JulianStremel/mrdiy_canabus/README.md

This project comprises a combination of software and hardware components designed to extract Controller Area Network (CAN) messages and generate practical gadgets. The primary objective is to receive CAN messages from a bus, extract the CAN-ID and Data from them, and subsequently transmit this information over ESPNow. The gadgets serve as ESPNow receivers, responsible for filtering and processing the received CAN-IDs and data to perform specific useful tasks.

## How to Install The Code

Certain firmware options (Gateway and Gadgets) can be conveniently installed online onto ESP32/ESP8266 devices with just a single click using the Chrome browser at <a href='https://mrdiyca.gitlab.io/mrdiy-esp-online-flasher'>https://mrdiyca.gitlab.io/mrdiy-esp-online-flasher</a>

## 3D Printable Files

You can find the STL files at my <a href='https://makerworld.com/en/@mrdiy'>MakerWorld profile</a>.

## The Gateway / Bridge

The gateway, sometimes called the bridge, consists of an ESP32 Dev Kit 1 board paired with a CAN bus shield (see below), directly connected to the car's CAN bus, typically via the OBDII port. See my full video below.

Gateway = ESP32 + Shield

MrDIY Wireless Gateway YouTube video (https://www.youtube.com/watch?v=XiqU5wpnupk)

<table>
<tr>

<td>
Power consumption while active: <100mA 

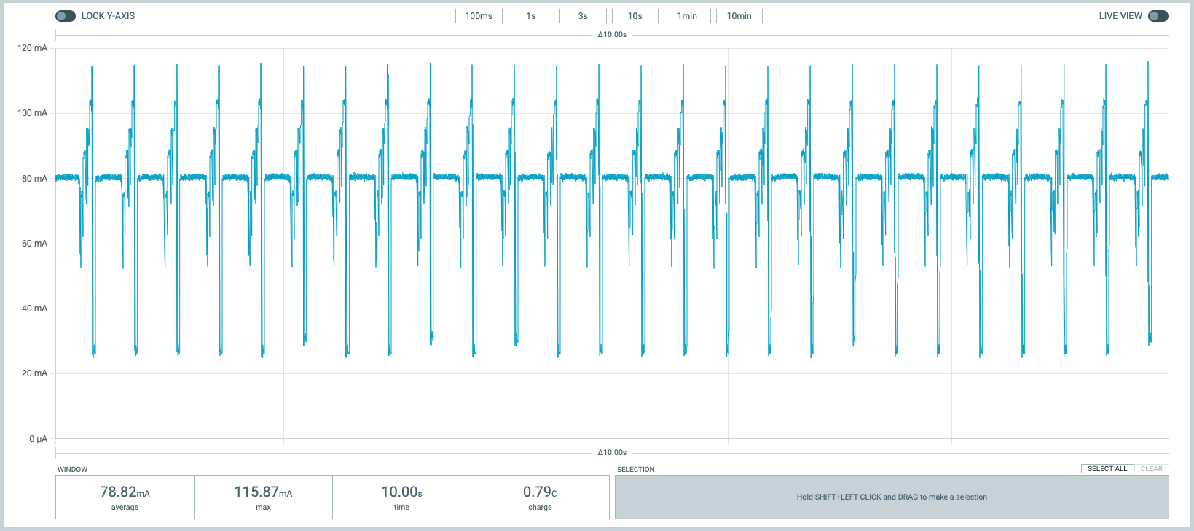
[picture p1: img/power_usage_active.png]
</td>
<td>
While asleep w/o LEDs: <10 mA 

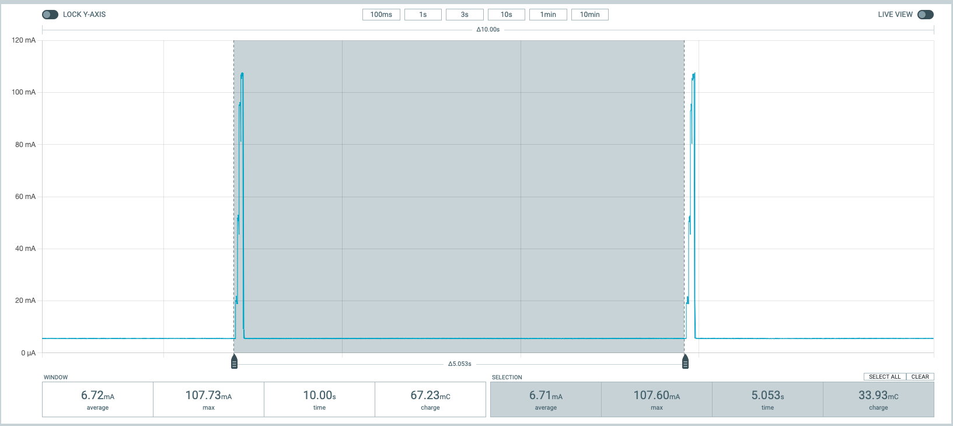
[picture p2: img/power_usage_idle.png]


</td>

</tr>
</table>

## SavvyCAN

I got SavvyCAN to work on the gateway. More details: https://youtu.be/NDBkXGyBT88
<br>The source code is inside the /esp32_savvycan folder
<br>Online flasher at https://mrdiyca.gitlab.io/mrdiy-esp-online-flasher

MrDIY CAN Shield YouTube video (https://www.youtube.com/watch?v=NDBkXGyBT88)

## The Shield

Get the ESP32 <a href="https://store.mrdiy.ca/p/esp32-can-bus-shield/"> CAN Shield here.</a>

I designed a shield for the ESP32 Dev Kit 1 board [<a href='https://geni.us/jS2Lx1W'>Amazon</a>, <a href='https://s.click.aliexpress.com/e/_DmhOymx'>AliExpress</a>] that adds a CAN bus transceiver and steps down the car's battery voltage down to a usable 3.3v.

MrDIY CAN Shield YouTube video (https://www.youtube.com/watch?v=Se2KCVyD7CM)

<br>**Version 1.0**: the original shield
<br>**Version 1.1**: added a voltage divider on GPIO32, a 120Ω CAN termination resistor, and a physical toggle switch enabling the CAN transceiver to toggle between “Listen-only” and “Do-Not-Transmit” modes.
<br>**Version 1.2 (current)**: added an OBD2 connector pinout, an extra LED on GPIO27, layout improvement, larger text, relocation of solder-jumpers to the top side, and the creation of a custom 3D printable case.

<br>

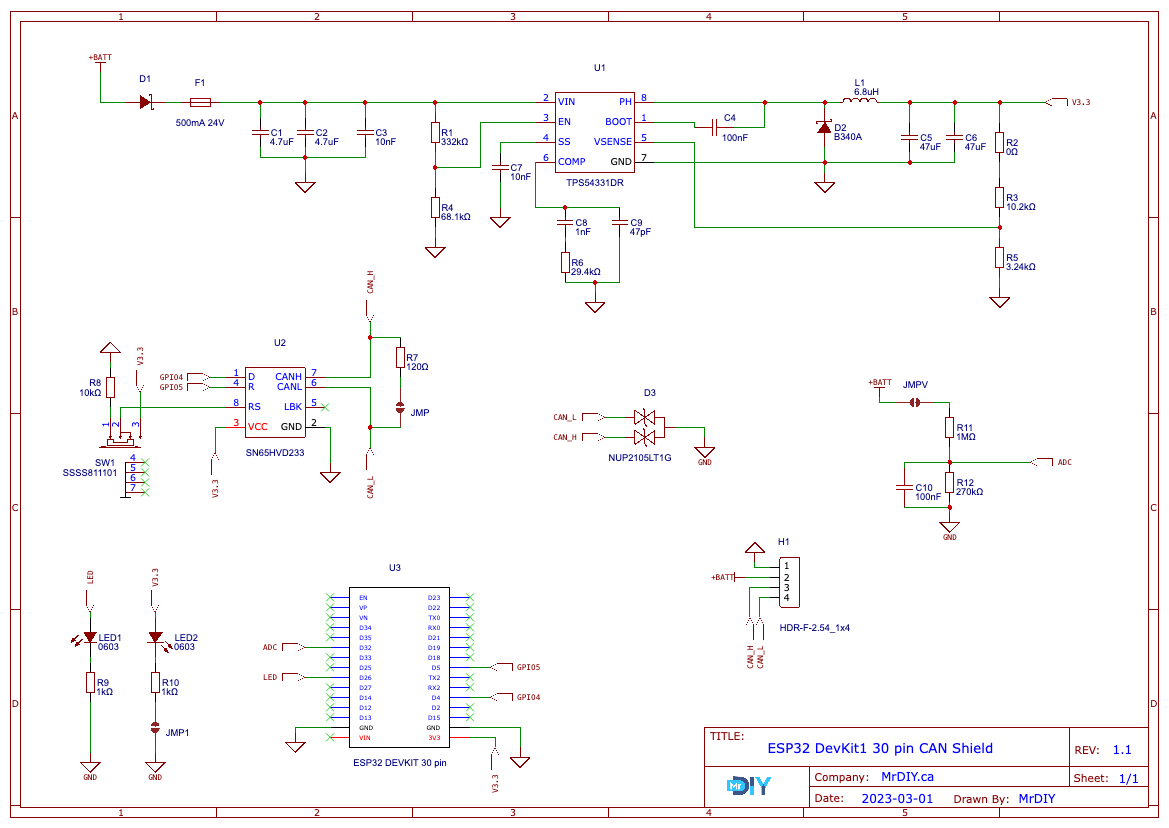
[picture p3: img/schematic_can_shield__esp32_v1.2.png]
Schematic


## The Gadgets

### Tesla Display

This gadget is a speedometer & battery SoC display screen for Tesla Model 3/Y.
<br>Online flasher at https://mrdiyca.gitlab.io/mrdiy-esp-online-flasher

MrDIY Gadget: Tesla Display YouTube video (https://www.youtube.com/watch?v=RgQMdmYFQI0)

### Garage door opener

This gadget waits for a signal from the car to trigger a relay to open or close a garage door. 
<br>The source code is inside the /gadget_garage_opener folder
<br>Online flasher at https://mrdiyca.gitlab.io/mrdiy-esp-online-flasher

MrDIY Gadget: Garage Door Opener YouTube video (https://www.youtube.com/watch?v=PJhCqS9ZGLU)

### SLCAN/LAWICEL & SavvyCAN

This gadget converts the ESPNow CAN messages into SLCAN/LAWICEL format to allow it to be used with SavvyCAN for sniffing, monitoring, analyzing and decoding CAN messages. 
<br>The source code is inside the /gadget_savvycan folder
<br>Online flasher at https://mrdiyca.gitlab.io/mrdiy-esp-online-flasher

MrDIY Gadget: SavvyCAN on ESP8266 YouTube video (https://www.youtube.com/watch?v=pontoaAcyZM)

### Other Gadgets

coming soon ...

## License

This project is licensed under the Creative Commons Attribution-NonCommercial-ShareAlike 4.0 International License.
