JulianStremel/mrdiy_canabus/img/gadget_tesla_screen.png

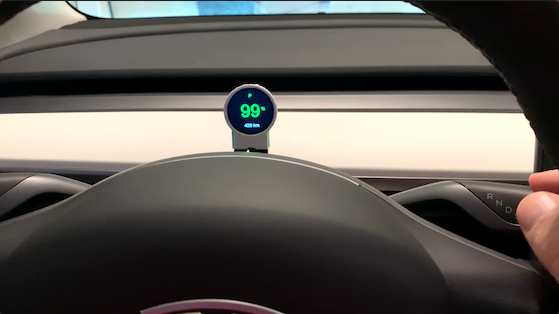
img/gadget_tesla_screen.png
