JulianStremel/mrdiy_canabus/img/savvycan.png

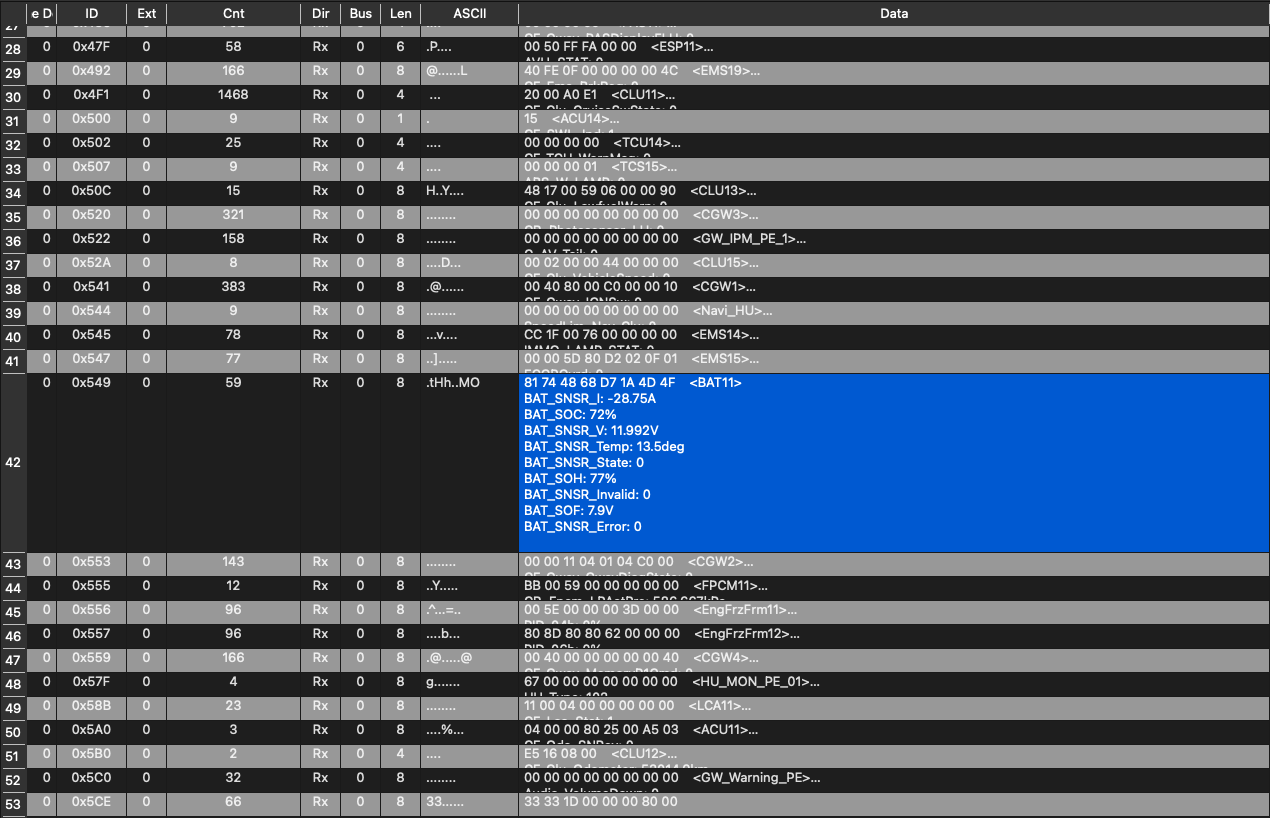
img/savvycan.png
