JulianStremel/mrdiy_canabus/esp32_savvycan/src/config.h

/*
 * config.h
 *
 * allows the user to configure static parameters.
 *
 * Note: Make sure with all pin defintions of your hardware that each pin number is
 *       only defined once.

 Copyright (c) 2013-2020 Collin Kidder, Michael Neuweiler, Charles Galpin

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
THE SOFTWARE IS PROVIDED "AS IS", WITHOUT WARRANTY OF ANY KIND,
EXPRESS OR IMPLIED, INCLUDING BUT NOT LIMITED TO THE WARRANTIES OF
MERCHANTABILITY, FITNESS FOR A PARTICULAR PURPOSE AND NONINFRINGEMENT.
IN NO EVENT SHALL THE AUTHORS OR COPYRIGHT HOLDERS BE LIABLE FOR ANY
CLAIM, DAMAGES OR OTHER LIABILITY, WHETHER IN AN ACTION OF CONTRACT,
TORT OR OTHERWISE, ARISING FROM, OUT OF OR IN CONNECTION WITH THE
SOFTWARE OR THE USE OR OTHER DEALINGS IN THE SOFTWARE.
*/

#ifndef CONFIG_H_
#define CONFIG_H_

#include <WiFi.h>
#include "esp32_can.h"
#include <Preferences.h>

//size to use for buffering writes to USB. On the ESP32 we're actually talking TTL serial to a TTL<->USB chip
#define SER_BUFF_SIZE       1024

//Buffer for CAN frames when sending over wifi. This allows us to build up a multi-frame packet that goes
//over the air all at once. This is much more efficient than trying to send a new TCP/IP packet for each and every
//frame. It delays frames from getting to the other side a bit but that's life.
//Probably don't set this over 2048 as the default packet size for wifi is 2312 including all overhead.
#define WIFI_BUFF_SIZE      2048

//Number of microseconds between hard flushes of the serial buffer (if not in wifi mode) or the wifi buffer (if in wifi mode)
//This keeps the latency more consistent. Otherwise the buffer could partially fill and never send.
#define SER_BUFF_FLUSH_INTERVAL 20000

#define CFG_BUILD_NUM   618
#define CFG_VERSION "Alpha Nov 29 2020"
#define PREF_NAME   "ESP32RET"
#define EVTV_NAME   "ESP32RET"
#define MACC_NAME   "CAN"

#define MARK_LIMIT  6   //# of our analog input pins to use for marking. Defaults to all of them. Send voltage to pin to trigger it

#define NUM_ANALOG  NUM_ANALOG_INPUTS   // we get the number of analogue inputs from variant.h
#define NUM_DIGITAL 6   // Not currently using digital pins on the ESP32
#define NUM_OUTPUT  6   // Ditto

#define NUM_BUSES   5   //max # of buses supported by any of the supported boards

//It's not even used on this hardware currently. But, slows down the blinks to make them more visible
#define BLINK_SLOWNESS  100 

#define A0_LED_PIN     33
#define A0_NUM_LEDS    0
#define A5_LED_PIN     25
#define A5_NUM_LEDS    0
#define BRIGHTNESS  190
#define LED_TYPE    WS2812B
#define COLOR_ORDER GRB

#define SW_EN     2
#define SW_MODE0  26
#define SW_MODE1  27

//How many devices to allow to connect to our WiFi telnet port?
#define MAX_CLIENTS 1

struct FILTER {  //should be 10 bytes
    uint32_t id;
    uint32_t mask;
    boolean extended;
    boolean enabled;
} __attribute__((__packed__));

struct CANFDSettings {
    uint32_t nomSpeed;
    uint32_t fdSpeed;
    boolean enabled;
    boolean listenOnly;
    boolean fdMode;
};

struct EEPROMSettings {
    CANFDSettings canSettings[NUM_BUSES];

    boolean useBinarySerialComm; //use a binary protocol on the serial link or human readable format?

    uint8_t logLevel; //Level of logging to output on serial line
    uint8_t systemType; //0 = A0RET, 1 = EVTV ESP32 Board, 2 = Macchine 5-CAN board
    
    boolean enableBT; //are we enabling bluetooth too?
    char btName[32];

    boolean enableLawicel;

    //if we're using WiFi then output to serial is disabled (it's far too slow to keep up)  
    uint8_t wifiMode; //0 = don't use wifi, 1 = connect to an AP, 2 = Create an AP
    char SSID[32];     //null terminated string for the SSID
    char WPA2Key[64]; //Null terminated string for the key. Can be a passphase or the actual key
} __attribute__((__packed__));

struct SystemSettings {
    uint8_t LED_CANTX;
    uint8_t LED_CANRX;
    uint8_t LED_LOGGING;
    uint8_t LED_CONNECTION_STATUS;
    boolean fancyLED;
    boolean txToggle; //LED toggle values
    boolean rxToggle;
    boolean logToggle;
    boolean lawicelMode;
    boolean lawicellExtendedMode;
    boolean lawicelAutoPoll;
    boolean lawicelTimestamping;
    int lawicelPollCounter;
    boolean lawicelBusReception[NUM_BUSES]; //does user want to see messages from this bus?
    int8_t numBuses; //number of buses this hardware currently supports.
    WiFiClient clientNodes[MAX_CLIENTS];
    WiFiClient wifiOBDClients[MAX_CLIENTS];
    boolean isWifiConnected;
    boolean isWifiActive;
};

class GVRET_Comm_Handler;
class SerialConsole;
class CANManager;
class LAWICELHandler;
class ELM327Emu;

extern EEPROMSettings settings;
extern SystemSettings SysSettings;
extern Preferences nvPrefs;
extern GVRET_Comm_Handler serialGVRET;
extern GVRET_Comm_Handler wifiGVRET;
extern SerialConsole console;
extern CANManager canManager;
extern LAWICELHandler lawicel;
extern ELM327Emu elmEmulator;
extern char deviceName[20];
extern char otaHost[40];
extern char otaFilename[100];
extern CAN_COMMON *canBuses[NUM_BUSES];

#endif /* CONFIG_H_ */
