JulianStremel/mrdiy_canabus/esp32_savvycan/src/ESP32RET.ino

/*
 ESP32RET.ino

 Created: June 1, 2020
 Author: Collin Kidder

Copyright (c) 2014-2020 Collin Kidder, Michael Neuweiler

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
THE SOFTWARE IS PROVIDED "AS IS", WITHOUT WARRANTY OF ANY KIND,
EXPRESS OR IMPLIED, INCLUDING BUT NOT LIMITED TO THE WARRANTIES OF
MERCHANTABILITY, FITNESS FOR A PARTICULAR PURPOSE AND NONINFRINGEMENT.
IN NO EVENT SHALL THE AUTHORS OR COPYRIGHT HOLDERS BE LIABLE FOR ANY
CLAIM, DAMAGES OR OTHER LIABILITY, WHETHER IN AN ACTION OF CONTRACT,
TORT OR OTHERWISE, ARISING FROM, OUT OF OR IN CONNECTION WITH THE
SOFTWARE OR THE USE OR OTHER DEALINGS IN THE SOFTWARE.
 */
#include "config.h"
#include <esp32_can.h>
#include <SPI.h>
#include <Preferences.h>
#include <FastLED.h>
#include "ELM327_Emulator.h"
#include "SerialConsole.h"
#include "wifi_manager.h"
#include "gvret_comm.h"
#include "can_manager.h"
#include "lawicel.h"

byte i = 0;

uint32_t lastFlushMicros = 0;

bool markToggle[6];
uint32_t lastMarkTrigger = 0;

EEPROMSettings settings;
SystemSettings SysSettings;
Preferences nvPrefs;
char deviceName[20];
char otaHost[40];
char otaFilename[100];

uint8_t espChipRevision;

ELM327Emu elmEmulator;

WiFiManager wifiManager;

GVRET_Comm_Handler serialGVRET; //gvret protocol over the serial to USB connection
GVRET_Comm_Handler wifiGVRET; //GVRET over the wifi telnet port
CANManager canManager; //keeps track of bus load and abstracts away some details of how things are done
LAWICELHandler lawicel;

SerialConsole console;

CRGB leds[A5_NUM_LEDS]; //A5 has the largest # of LEDs so use that one even for A0 or EVTV

CAN_COMMON *canBuses[NUM_BUSES];

//initializes all the system EEPROM values. Chances are this should be broken out a bit but
//there is only one checksum check for all of them so it's simple to do it all here.
void loadSettings()
{
    Logger::console("Loading settings....");

    //Logger::console("%i\n", espChipRevision);

    for (int i = 0; i < NUM_BUSES; i++) canBuses[i] = nullptr;

    nvPrefs.begin(PREF_NAME, false);

    settings.useBinarySerialComm = nvPrefs.getBool("binarycomm", false);
    settings.logLevel = nvPrefs.getUChar("loglevel", 1); //info
    settings.wifiMode = nvPrefs.getUChar("wifiMode", 2); //Wifi defaults to creating an AP
    //settings.enableBT = nvPrefs.getBool("enable-bt", false);
    settings.enableBT = nvPrefs.getBool("enable-bt", true); // change julian
    settings.enableLawicel = nvPrefs.getBool("enableLawicel", true);
    settings.systemType = 0; //nvPrefs.getUChar("systype", (espChipRevision > 2) ? 0 : 1); //0 = A0, 1 = EVTV ESP32

    if (settings.systemType == 0)
    {
        canBuses[0] = &CAN0;
        SysSettings.LED_CANTX = 26;
        SysSettings.LED_CANRX = 27;
        SysSettings.LED_LOGGING = 35;
        SysSettings.LED_CONNECTION_STATUS = 0;
        SysSettings.fancyLED = false;
        SysSettings.logToggle = false;
        SysSettings.txToggle = true;
        SysSettings.rxToggle = true;
        SysSettings.lawicelAutoPoll = false;
        SysSettings.lawicelMode = false;
        SysSettings.lawicellExtendedMode = false;
        SysSettings.lawicelTimestamping = false;
        SysSettings.numBuses = 1;
        SysSettings.isWifiActive = false;
        SysSettings.isWifiConnected = false;
        strcpy(deviceName, MACC_NAME);
        strcpy(otaHost, "");
        strcpy(otaFilename, "");
        pinMode(SysSettings.LED_CANTX, OUTPUT);
        pinMode(SysSettings.LED_CANRX, OUTPUT);
        digitalWrite(SysSettings.LED_CANTX, LOW);
        digitalWrite(SysSettings.LED_CANRX, LOW);
        delay(100);
        FastLED.addLeds<LED_TYPE, A0_LED_PIN, COLOR_ORDER>(leds, A0_NUM_LEDS).setCorrection( TypicalLEDStrip );
        FastLED.setBrightness(  BRIGHTNESS );
        leds[0] = CRGB::Red;
        FastLED.show();
        //pinMode(21, OUTPUT);
        //digitalWrite(21, LOW);
        //  CAN0.setCANPins(GPIO_NUM_4, GPIO_NUM_5);     // use this for shield v1.3 and later
        CAN0.setCANPins(GPIO_NUM_5, GPIO_NUM_4); // use this for shield v1.2 and earlier
    }

    if (nvPrefs.getString("SSID", settings.SSID, 32) == 0)
    {
        strcpy(settings.SSID, deviceName);
        strcat(settings.SSID, "-Wireless");
   }

    if (nvPrefs.getString("wpa2Key", settings.WPA2Key, 64) == 0)
    {
        strcpy(settings.WPA2Key, "mrdiy.ca");
    }
    if (nvPrefs.getString("btname", settings.btName, 32) == 0)
    {
        strcpy(settings.btName, "ELM327-");
        strcat(settings.btName, deviceName);
    }

    char buff[80];
    for (int i = 0; i < SysSettings.numBuses; i++)
    {
        sprintf(buff, "can%ispeed", i);
        settings.canSettings[i].nomSpeed = nvPrefs.getUInt(buff, 500000);
        sprintf(buff, "can%i_en", i);
        settings.canSettings[i].enabled = nvPrefs.getBool(buff, (i < 2)?true:false);
        sprintf(buff, "can%i-listenonly", i);
        settings.canSettings[i].listenOnly = nvPrefs.getBool(buff, false);
        sprintf(buff, "can%i-fdspeed", i);
        settings.canSettings[i].fdSpeed = nvPrefs.getUInt(buff, 5000000);
        sprintf(buff, "can%i-fdmode", i);
        settings.canSettings[i].fdMode = nvPrefs.getBool(buff, false);
    }

    nvPrefs.end();

    Logger::setLoglevel((Logger::LogLevel)settings.logLevel);

    for (int rx = 0; rx < NUM_BUSES; rx++) SysSettings.lawicelBusReception[rx] = true; //default to showing messages on RX 
}

void setup()
{
    //delay(5000); //just for testing. Don't use in production

    espChipRevision = ESP.getChipRevision();

    Serial.begin(115200); //for production
    //Serial.begin(115200); //for testing

    SysSettings.isWifiConnected = false;

    loadSettings();

    //If you enable PSRAM then BluetoothSerial will kill everything via a heap error. These calls
    //try to debug that. But, no dice yet. :(
    //heap_caps_print_heap_info(MALLOC_CAP_8BIT);

    if (settings.enableBT) 
    {
        Serial.println("Starting bluetooth");
        elmEmulator.setup();
        if (SysSettings.fancyLED && (settings.wifiMode == 0) )
        {
            leds[0] = CRGB::Green;
            FastLED.show();
        }
    }
    /*else*/ wifiManager.setup();

    //heap_caps_print_heap_info(MALLOC_CAP_8BIT);

    //heap_caps_print_heap_info(MALLOC_CAP_8BIT);
    Serial.println("");
    Serial.println("===================================");
    Serial.println("        MrDIY.ca CAN Shield        ");
    Serial.println("===================================");
    Serial.println("");
    //Serial.print("Build number: ");
    //Serial.println(CFG_BUILD_NUM);

    canManager.setup();

    SysSettings.lawicelMode = false;
    SysSettings.lawicelAutoPoll = false;
    SysSettings.lawicelTimestamping = false;
    SysSettings.lawicelPollCounter = 0;
    
    elmEmulator.setup();

    Serial.print("Free heap: ");
    Serial.println(esp_get_free_heap_size());

    Serial.print("Done with init\n");
}
 
/*
Send a fake frame out USB and maybe to file to show where the mark was triggered at. The fake frame has bits 31 through 3
set which can never happen in reality since frames are either 11 or 29 bit IDs. So, this is a sign that it is a mark frame
and not a real frame. The bottom three bits specify which mark triggered.
*/
void sendMarkTriggered(int which)
{
    CAN_FRAME frame;
    frame.id = 0xFFFFFFF8ull + which;
    frame.extended = true;
    frame.length = 0;
    frame.rtr = 0;
    canManager.displayFrame(frame, 0);
}

/*
Loop executes as often as possible all the while interrupts fire in the background.
The serial comm protocol is as follows:
All commands start with 0xF1 this helps to synchronize if there were comm issues
Then the next byte specifies which command this is.
Then the command data bytes which are specific to the command
Lastly, there is a checksum byte just to be sure there are no missed or duped bytes
Any bytes between checksum and 0xF1 are thrown away

Yes, this should probably have been done more neatly but this way is likely to be the
fastest and safest with limited function calls
*/
void loop()
{
    //uint32_t temp32;    
    bool isConnected = false;
    int serialCnt;
    uint8_t in_byte;

    /*if (Serial)*/ isConnected = true;

    if (SysSettings.lawicelPollCounter > 0) SysSettings.lawicelPollCounter--;
    //}

    canManager.loop();
    /*if (!settings.enableBT)*/ wifiManager.loop();

    size_t wifiLength = wifiGVRET.numAvailableBytes();
    size_t serialLength = serialGVRET.numAvailableBytes();
    size_t maxLength = (wifiLength>serialLength) ? wifiLength : serialLength;

    //If the max time has passed or the buffer is almost filled then send buffered data out
    if ((micros() - lastFlushMicros > SER_BUFF_FLUSH_INTERVAL) || (maxLength > (WIFI_BUFF_SIZE - 40)) ) 
    {
        lastFlushMicros = micros();
        if (serialLength > 0) 
        {
            Serial.write(serialGVRET.getBufferedBytes(), serialLength);
            serialGVRET.clearBufferedBytes();
        }
        if (wifiLength > 0)
        {
            wifiManager.sendBufferedData();
        }
    }

    serialCnt = 0;
    while ( (Serial.available() > 0) && serialCnt < 128 ) 
    {
        serialCnt++;
        in_byte = Serial.read();
        serialGVRET.processIncomingByte(in_byte);
    }

    elmEmulator.loop();
}
