JulianStremel/mrdiy_canabus/(commit log)

2023-08-03 added gateway and sample gadget code
2024-01-26 added STL file
2024-06-15 added ESP32RET code
2024-09-24 added notes for pin configuration
2024-09-29 updated the gateway for Arduino
2024-10-02 updated STL files source
2025-02-09 added assembly instructions
2025-02-09 update assembly images
2025-02-09 Fixed assembly images path
